dubnubdubnub/UDB-S-SH/udb-s.kicad_pcb

## KiCad design udb-s.kicad_pcb (2026-10-15)

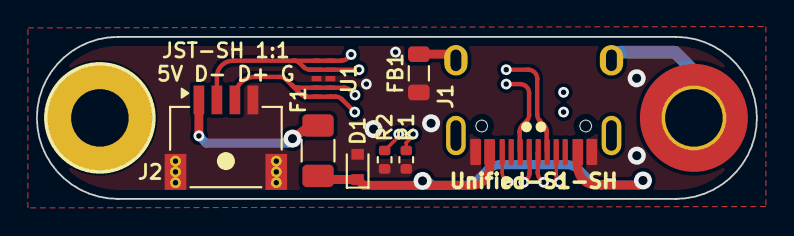
[picture p1: board udb-s.kicad_pcb from above]

Board: 4 copper layers, 40.0 x 9.0 mm, 10 parts (0 on the bottom side), 8 nets.

Parts:
D1: ESD5Z5V0; D_SOD-523
F1: SMD0805-050-16V; Fuse_1206_3216Metric
FB1: GZ2012D601TF; L_0805_2012Metric
H1: MountingHole; MountingHole_3.2mm_M3_DIN965_Pad_TopBottom
H2: MountingHole; MountingHole_3.2mm_M3_DIN965_Pad_TopOnly
J1: TYPE-C-31-M-12; HRO-TYPE-C-31-M-12-Assembly
J2: XY-SH1.0-4A61
R1, R2: 5.1k; R_0402_1005Metric
U1: TPD4E05U06DQAR; USON-10_2.5x1.0mm_P0.5mm

Connections:
5V: F1.2, J2.1
D+: J1.A6 (D+), J1.B6 (D+), J2.3, U1.4 (D2+), U1.5 (D2-), U1.6 (NC), U1.7 (NC)
D-: J1.A7 (D-), J1.B7 (D-), J2.2, U1.1 (IO1), U1.2 (IO2), U1.9 (NC), U1.10 (NC)
GND: D1.2 (A2), FB1.2, J1.A1 (GND), J1.B1 (GND), J2.4, J2.MP (MountPin), R1.1, R2.2, U1.3 (GND), U1.8 (GND)
GNDPWR: FB1.1, H1.1, J1.S1 (SHIELD)
unnamed: J1.A5 (CC1), R1.2
unnamed: J1.B5 (CC2), R2.1
VBUS: D1.1 (A1), F1.1, J1.A4 (VBUS), J1.B4 (VBUS)
