dubnubdubnub/UDB-S-SH/(commit log)

2026-10-15 Swap J2 Pico-EZmate for JST-SH compatible XYECONN XY-SH1.0-4A61
    Same 1:1 pinout (5V, D-, D+, GND). Side-entry header sits where the
    EZmate was, opening toward the board's inner edge. 5V/D-/D+ stubs
    moved onto the 1.00 mm pins, F1's 5V via nudged 0.25 mm for clearance
    to the new mounting pad, GND pour refilled. Files stay in KiCad 6
    format.
    [udb-s.kicad_pcb, udb-s.kicad_sch]
2026-10-15 Replace hand-made Type-C STEP with the LCSC/EasyEDA TYPE-C-31-M-12 model
    EasyEDA watermark solids removed and the shell recoloured to metal
    grey. Aligned to the footprint on the NPTH pegs and shell slots; the
    library footprint now carries the same model as the board.
    [udb-s.kicad_pcb]
2026-10-15 Reinforce J2 mounting pads; S1-SH silkscreen
    J2's mounting pads get a B.Cu mirror and three 0.6/0.3 plated holes
    each, as on the EZmate footprint (0.3 drill keeps 0.15 annular ring).
    Silkscreen: front reads 'JST-SH 1:1' and the J2 pin order, board name
    'Unified-S1-SH'; back carries 'Unified-S1-SH V1.1' and this repo URL.
    GND pour refilled.
    [udb-s.kicad_pcb]
